AriaMaz/AutoMV-Feeder/README.md

# AutoMV-Feeder

<a href="https://github.com/AriaMaz">
    
</a>

Aria Maz <br>
Michael Wang <br> 
Naser AI-Obeidat <br>
<p><p>
<br>

<h3 align="left">Project Description</h3>
Autonomous pet feeder with adjustable foods, portion sizes, and feeding times that dispenses food with a maximum weight error of 4%. <br>
- Detects pets with a 98% accuracy using a camera, MV Python script, and 1 image of each pet uploaded by the user.

<details>
<summary style="font-weight:bold;">Setup</summary>
To use this model, run the following command in your terminal based on your operating system below. Creating a virtual environment and downloading the required package managers, interpreters, and libraries is recommended.

#### MacOS

```html
<p>/bin/bash -c "$(curl -fsSL https://raw.githubusercontent.com/Homebrew/install/HEAD/install.sh)" && brew install python3 arduino && mkdir PetFeederProject && cd PetFeederProject && python3 -m venv PetFeederEnv && source PetFeederEnv/bin/activate && pip install opencv-python pyserial</p>
```

#### Windows

```html
<p>mkdir PetFeederProject; cd PetFeederProject; python -m venv PetFeederEnv; .\PetFeederEnv\Scripts\Activate; pip install opencv-python pyserial; choco install arduino</p>
```

#### Linux

```html
<p>sudo apt update && sudo apt install python3-venv python3-pip arduino && mkdir PetFeederProject && cd PetFeederProject && python3 -m venv PetFeederEnv && source PetFeederEnv/bin/activate && pip install opencv-python pyserial</p>
```
  </details>
<h3 align="center">Click on the image below to download the Conceptual Design Report for this project</h3>
<div align="center">
    <a href="https://github.com/AriaMaz/AutoCV-Feeder/files/13792210/AutoCVFConseptualDesignReport.pdf">
        PDF Preview
    </a>
</div>
